chansen1395/printable-cabber/BOM.md

# Bill of materials

Everything is bought new. Prices checked **2026-10-22**: **L** = seen on a listing that day, **E** = typical price. Check before buying.

| # | Group | Item | Spec | Qty | Price | Status | Source | Note |
|---|---|---|---|---|---|---|---|---|
| 1 | Drive | Motor | 775 DC motor, 12 V ~4,000 RPM (sold as "12 V 4000 / 24 V 8000 RPM"), 5 mm shaft | 1 | $12.99 | L | [link](https://www.walmart.com/c/kp/volt-dc-motor) | Run it on 12 V. The model is checked for this 4,000 RPM speed only; the clash check fails at 6,000 and 8,000 RPM |
| 2 | Drive | Speed control | PWM DC motor speed controller, 12–24 V, 10 A, knob with on/off | 1 | $7.70 | L | [link](https://www.walmart.com/ip/13872166347) |  |
| 3 | Drive | Power supply | 12 V 10 A (120 W) power brick + 5.5 mm barrel-jack pigtail | 1 | $11.00 | L | [link](https://www.ebay.com/itm/396982511231) | $9.17 listing + ~$1 pigtail. Any 12 V supply that gives 8 A or more works. |
| 4 | Drive | Motor pulley | GT2 20-tooth aluminum pulley, 5 mm bore (3D-printer part) | 1 | $1.50 | E | [search](https://www.amazon.com/s?k=GT2+20+tooth+pulley+5mm+bore) | Usually sold in 5-packs |
| 5 | Drive | Belt | GT2 6 mm closed-loop belt, 500 mm | 1 | $5.73 | L | [link](https://www.ebay.com/itm/283194907394) |  |
| 6 | Arbor | Bolt | 1/2-13 × 14 in hex bolt, ≥ 1¼ in of thread; pick one that rolls straight | 1 | $4.00 | E | [search](https://www.amazon.com/s?k=1/2-13+x+14+hex+bolt) | The model is checked for a 14 in bolt only |
| 7 | Arbor | Nut and washers | 1/2-13 nut + one 1/2 × 1½ in fender washer | 1 | $1.50 | E | [search](https://www.amazon.com/s?k=1/2+fender+washer+1-1/2) |  |
| 8 | Arbor | Bearings | R8-2RS, 1/2 × 1⅛ × 5/16 in (10-pack; 2 used) | 1 | $7.75 | L | [link](https://www.shopabunda.com/products/pgn-10-pack-r8-2rs-bearing-lubricated-chrome-steel-sealed-ball-bearing-1-2-x1-1-8-x5-16-bearings-with-rubber-seal-high-rpm-suppor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) |  |
| 9 | Water | Pump | 12 V mini submersible pump, 240 L/h | 1 | $10.15 | L | [link](https://www.walmart.com/ip/17108059565) | $7.16 + $2.99 shipping; runs off the same 12 V supply |
| 10 | Water | Drip lines | Aquarium airline tube 6 mm OD, 4 m + 5 airline control valves | 1 | $6.00 | E | [search](https://www.amazon.com/s?k=aquarium+airline+tubing+with+control+valves) |  |
| 11 | Base | Board | 1×12 pine, 24 in (or any ¾ in plywood scrap ≥ 610 × 286 mm) | 1 | $6.00 | E | [search](https://www.amazon.com/s?k=1x12+pine+board+2+ft) |  |
| 12 | Base | Screws and wire | ~20 #8 × 1¼ in wood screws; 8 × M4 × 30 + nuts; 2 m of 18 AWG wire | 1 | $6.00 | E | [search](https://www.amazon.com/s?k=M4+x+30+screws+nuts+assortment) |  |
| | | **Total** | | | **$80.32** | | | |

Plus about 2.5 kg of PETG for the prints (~$35–40 if you don't have it).

## Wheels and pads (consumables)

| Item | Spec | Qty | Price | Status | Source |
|---|---|---|---|---|---|
| Wheels | 4 × 6 × 1½ in diamond wheels, 1 in arbor: 80 + 220 hard, 280 + 600 resin (~$24–36 each) | 4 | $120.00 | L | [link](https://www.walmart.com/c/kp/lapidary-wheels) |
| End-disk pads | 6 in hook-and-loop diamond pads (1,200 → 8,000 range) + a 6 in PSA hook-and-loop sheet | 1 | $25.00 | E | [search](https://www.amazon.com/s?k=6+inch+diamond+polishing+pads+hook+and+loop) |
| Dressing stick | Silicon carbide dressing stick | 1 | $8.00 | E | [search](https://www.amazon.com/s?k=silicon+carbide+dressing+stick) |

**Machine $80.32 + wheels and pads $153.00 = $233.32.**

Ways to spend less: use scrap wood, buy 2 bearings instead of a 10-pack, and use any 12 V supply you already have (an old PC power supply or LED-strip brick). That brings the machine to roughly $60.
