chansen1395/printable-cabber/cad/step/cabber_assembly.step

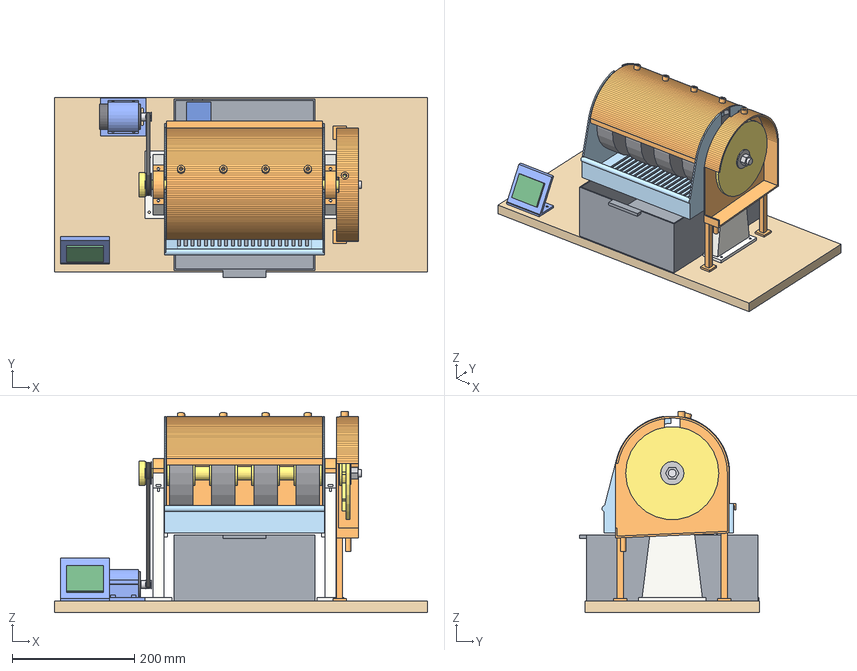
[picture p3: CAD file, 2026-11-05]
cad/step/cabber_assembly.step
610.0 x 295.0 x 329.0 mm
pedestal_L_0
pedestal_R_1
bearing_cap_2
bearing_cap_3
arbor_pulley_4
bushing_5
bushing_6
bushing_7
bushing_8
pan_9
hood_10
disk_shroud_11
backing_plate_12
tank_13
motor_cradle_14
motor_strap_15
control_mount_16
spacer_A_17
spacer_gap_18
spacer_gap_19
spacer_gap_20
spacer_B_21
spacer_C_22
board_0
bolt_1
nut_2
washer_3
bearing_4
bearing_5
wheel_6
wheel_7
wheel_8
wheel_9
belt_10
motor_11
motor_pulley_12
pump_13
pwm_board_14
