chansen1395/printable-cabber/cad/step/hood.step

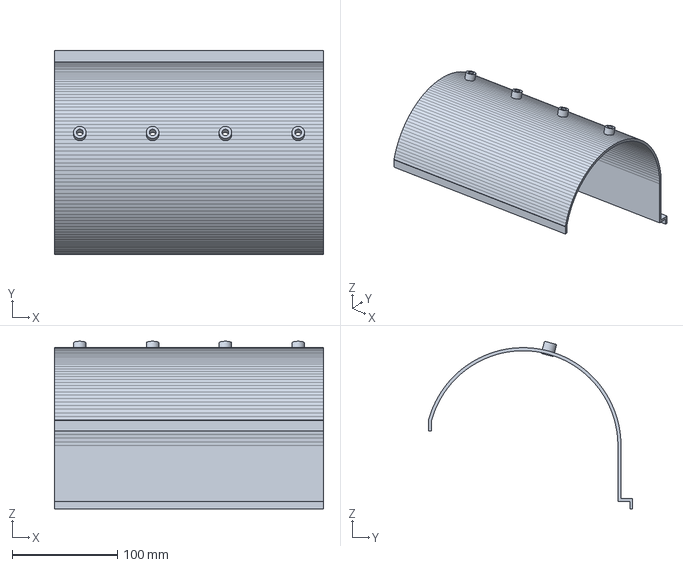
[picture p4: CAD file, 2026-11-05]
cad/step/hood.step
255.4 x 193.9 x 159.1 mm
