chansen1395/printable-cabber/cad/step/bearing_cap.step

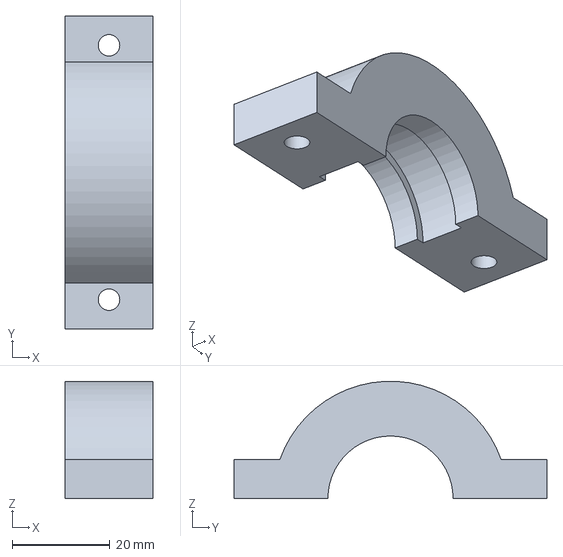
[picture p5: CAD file, 2026-11-05]
cad/step/bearing_cap.step
18.0 x 64.0 x 24.0 mm
