chansen1395/printable-cabber/cad/step/spacer_A.step

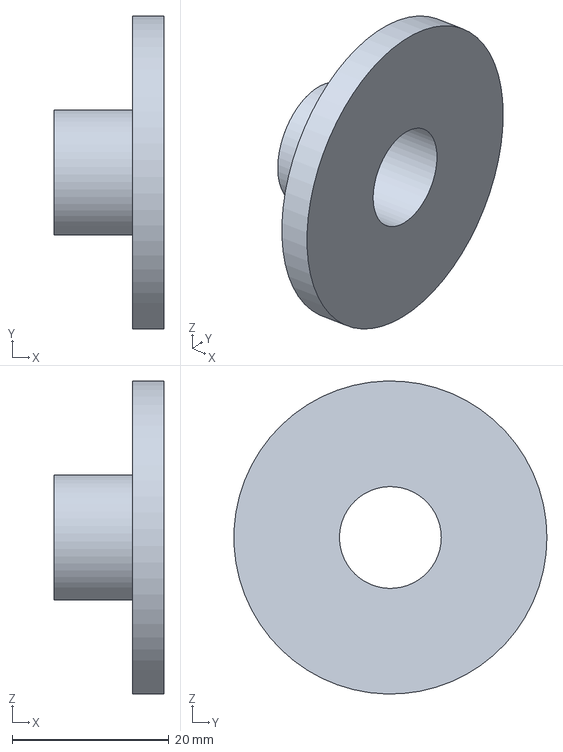
[picture p6: CAD file, 2026-11-05]
cad/step/spacer_A.step
14.0 x 40.0 x 40.0 mm
