chansen1395/printable-cabber/cad/step/spacer_gap.step

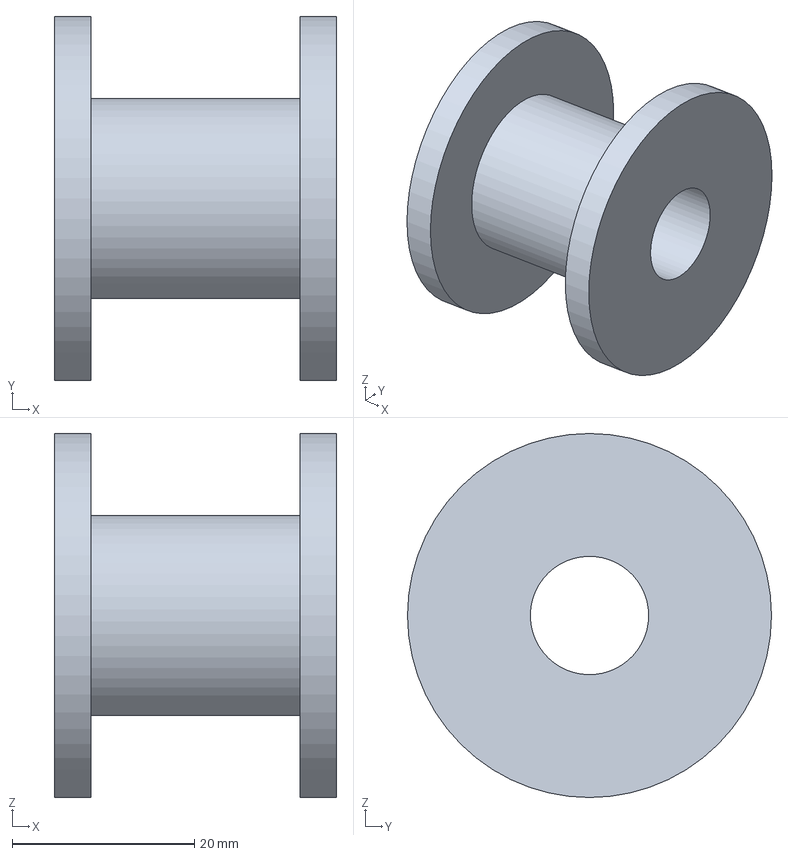
[picture p7: CAD file, 2026-11-05]
cad/step/spacer_gap.step
31.0 x 40.0 x 40.0 mm
