chansen1395/printable-cabber/cad/step/pedestal_L.step

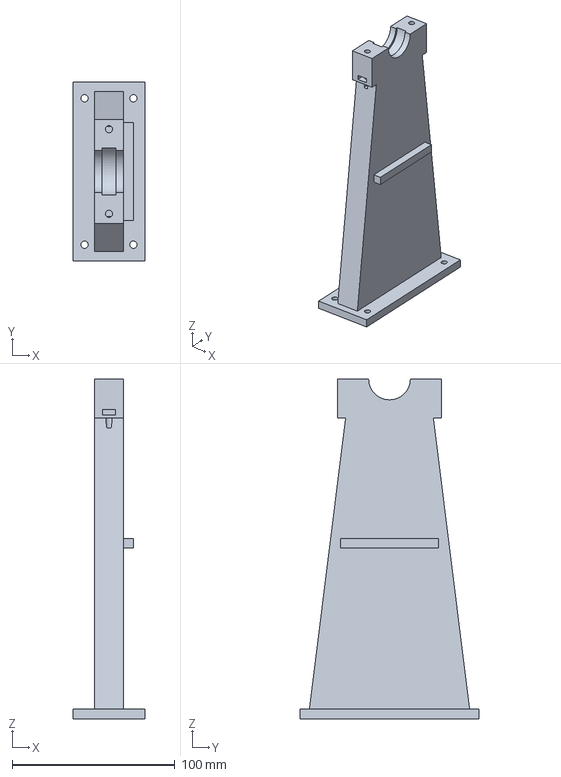
[picture p8: CAD file, 2026-11-05]
cad/step/pedestal_L.step
44.0 x 110.0 x 209.0 mm
