chansen1395/printable-cabber/cad/step/backing_plate.step

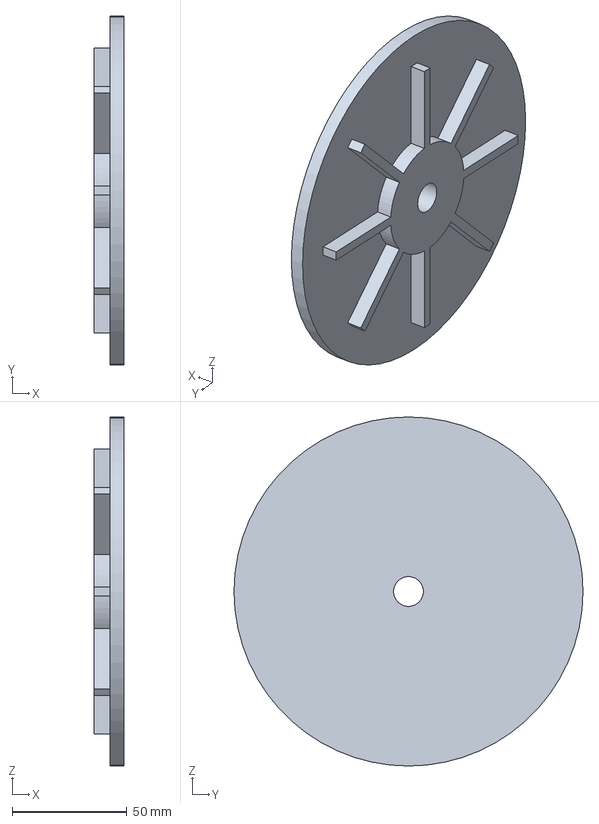
[picture p9: CAD file, 2026-11-05]
cad/step/backing_plate.step
13.0 x 152.4 x 152.4 mm
