chansen1395/printable-cabber/cad/step/motor_cradle.step

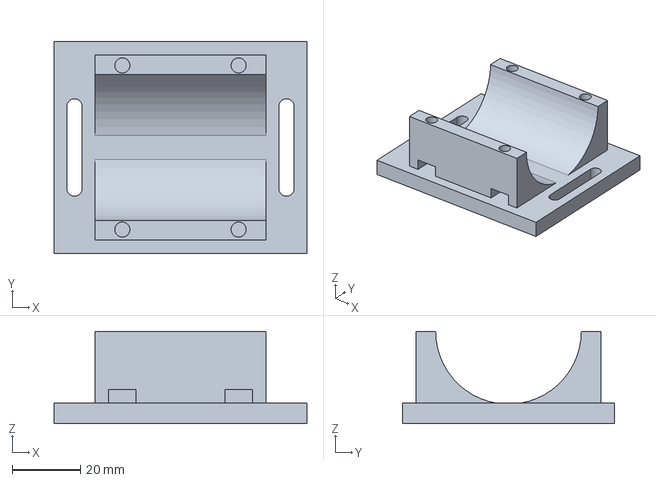
[picture p10: CAD file, 2026-11-05]
cad/step/motor_cradle.step
74.0 x 62.0 x 27.0 mm
