chansen1395/printable-cabber/cad/step/tank.step

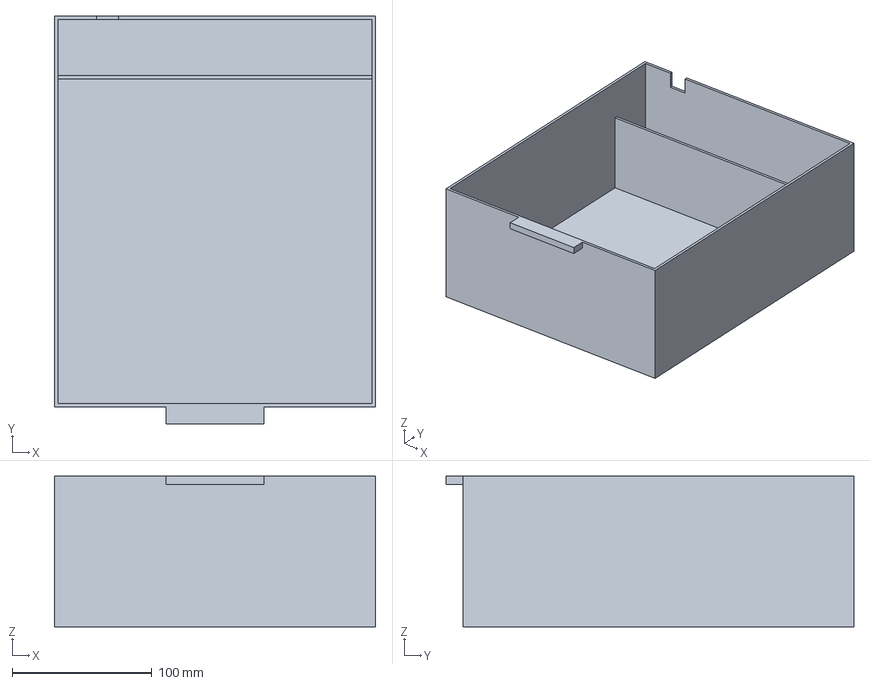
[picture p11: CAD file, 2026-11-05]
cad/step/tank.step
230.0 x 292.0 x 108.0 mm
