chansen1395/printable-cabber/cad/step/motor_strap.step

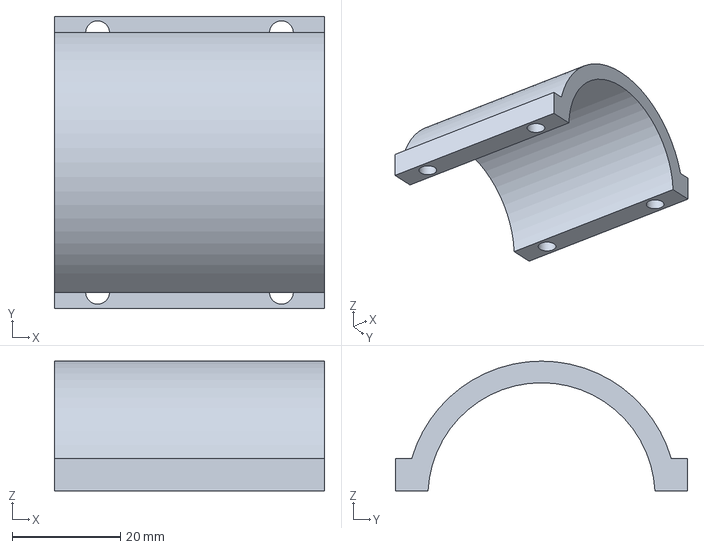
[picture p12: CAD file, 2026-11-05]
cad/step/motor_strap.step
50.0 x 54.0 x 24.0 mm
