chansen1395/printable-cabber/cad/step/bushing.step

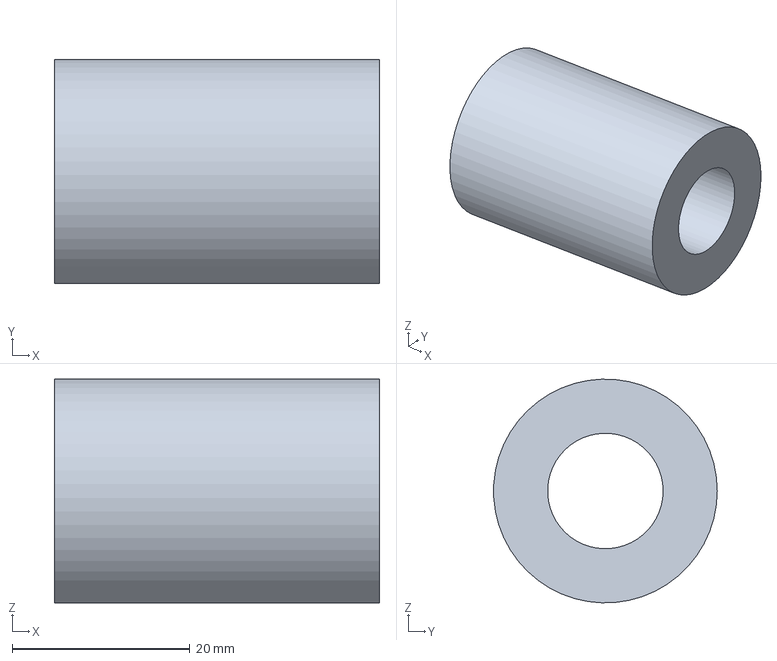
[picture p13: CAD file, 2026-11-05]
cad/step/bushing.step
36.6 x 25.2 x 25.2 mm
