chansen1395/printable-cabber/cad/step/arbor_pulley.step

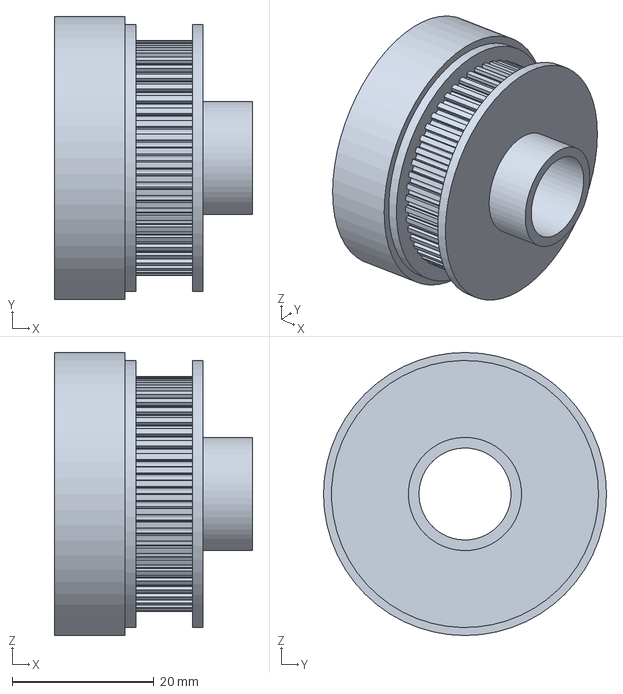
[picture p14: CAD file, 2026-11-05]
cad/step/arbor_pulley.step
28.0 x 40.0 x 40.0 mm
