chansen1395/printable-cabber/cad/step/control_mount.step

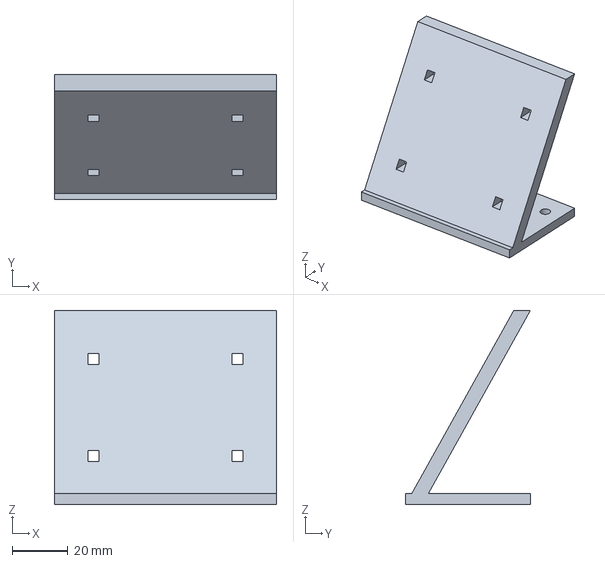
[picture p15: CAD file, 2026-11-05]
cad/step/control_mount.step
80.0 x 45.0 x 70.0 mm
