chansen1395/printable-cabber/cad/step/spacer_C.step

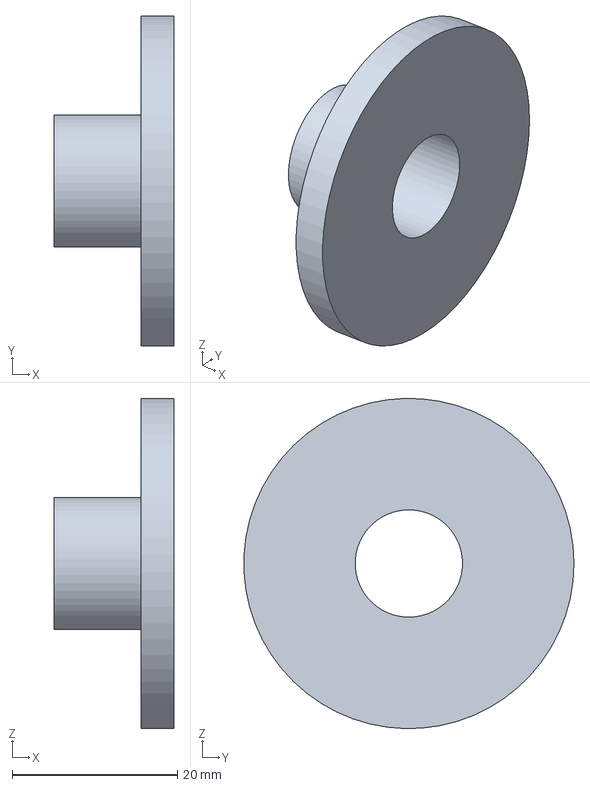
[picture p16: CAD file, 2026-11-05]
cad/step/spacer_C.step
14.5 x 40.0 x 40.0 mm
