chansen1395/printable-cabber/cad/step/pan.step

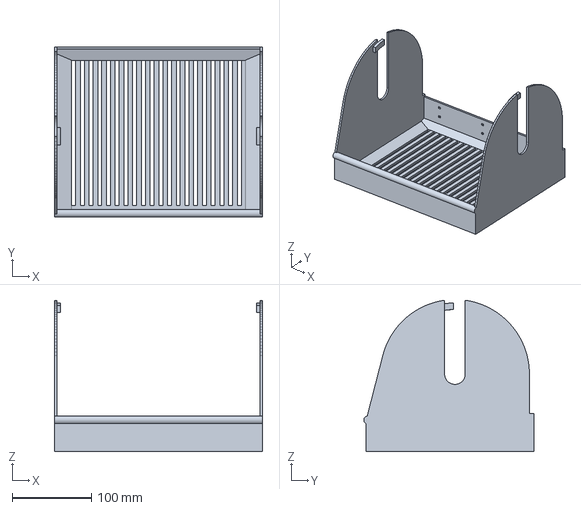
[picture p17: CAD file, 2026-11-05]
cad/step/pan.step
262.4 x 215.0 x 191.1 mm
