chansen1395/printable-cabber/cad/step/disk_shroud.step

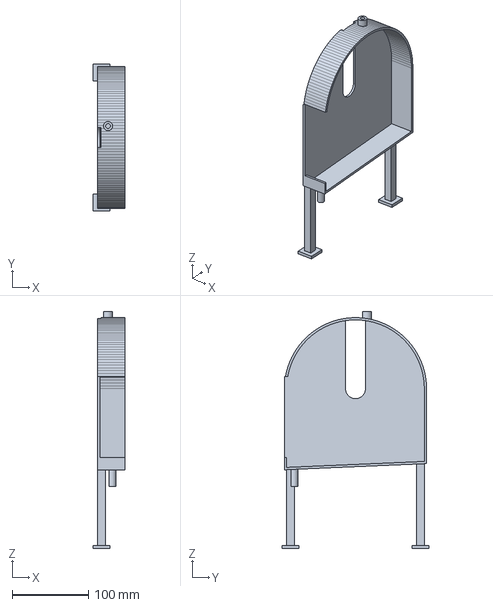
[picture p18: CAD file, 2026-11-05]
cad/step/disk_shroud.step
41.5 x 192.0 x 310.0 mm
