chansen1395/printable-cabber/(list of files, cad)

Other CAD files:
cad/step/pedestal_R.step
cad/step/spacer_B.step
cad/stl/arbor_pulley.stl
cad/stl/backing_plate.stl
cad/stl/bearing_cap.stl
cad/stl/bushing.stl
cad/stl/control_mount.stl
cad/stl/disk_shroud.stl
cad/stl/hood.stl
cad/stl/motor_cradle.stl
cad/stl/motor_strap.stl
cad/stl/pan.stl
cad/stl/pedestal_L.stl
cad/stl/pedestal_R.stl
cad/stl/spacer_A.stl
cad/stl/spacer_B.stl
cad/stl/spacer_C.stl
cad/stl/spacer_gap.stl
cad/stl/tank.stl
