chansen1395/printable-cabber/renders/assembly_exploded.png

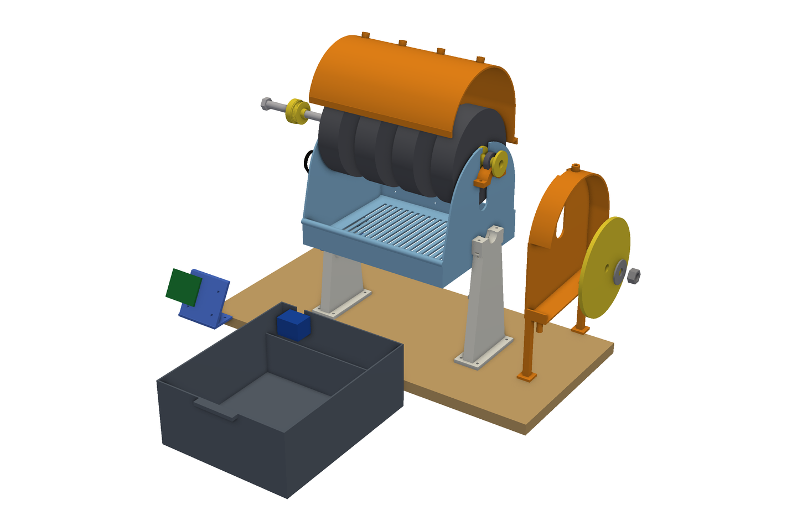
renders/assembly_exploded.png
