chansen1395/printable-cabber/renders/assembly_front.png

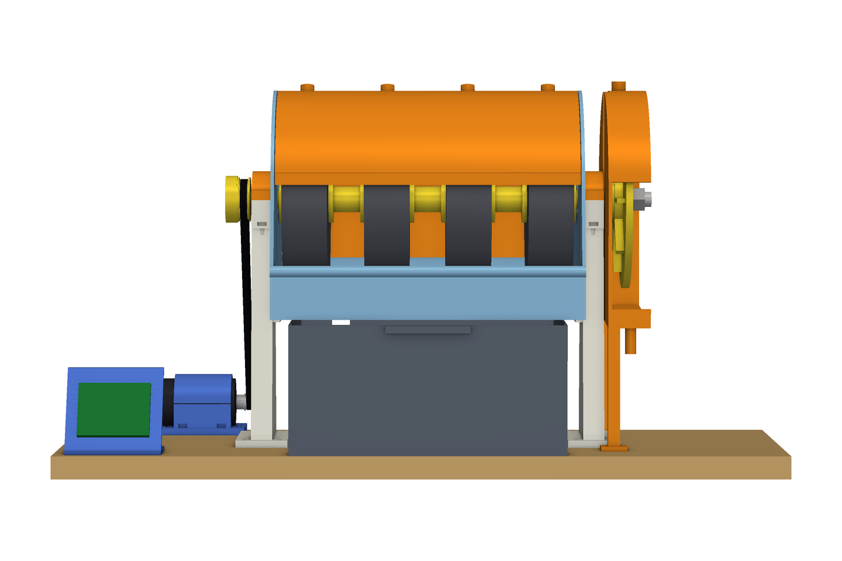
renders/assembly_front.png
