chansen1395/printable-cabber/renders/assembly_left.png

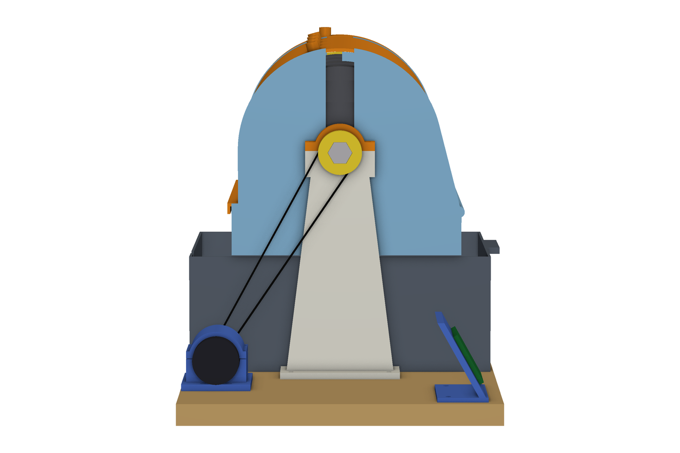
renders/assembly_left.png
